FaisalBinHassan/Bioreactor-Vaccine-Production-Plant-for-Tuberculosis/DASHBOARD/dashboard.jpg

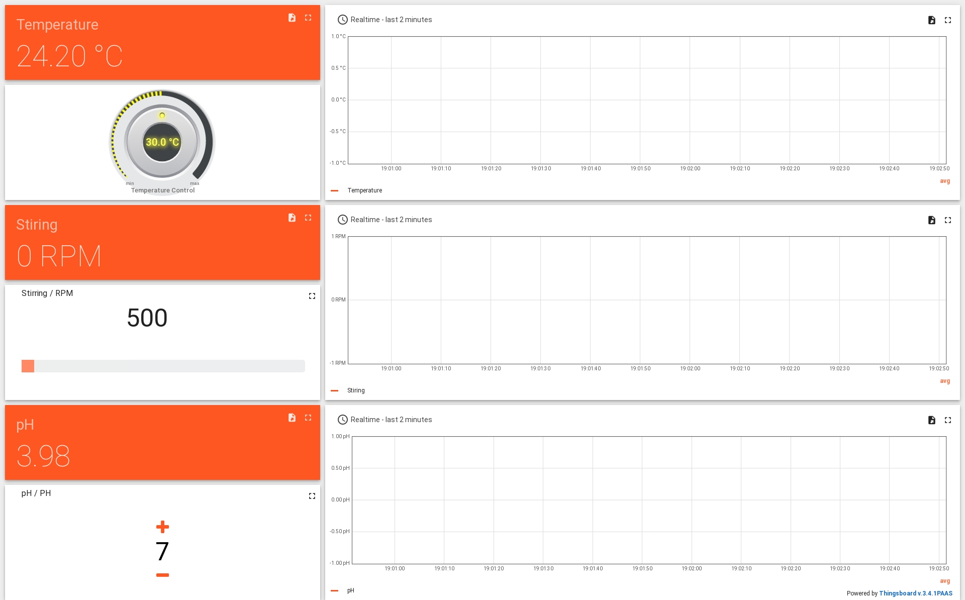
DASHBOARD/dashboard.jpg
