FaisalBinHassan/Bioreactor-Vaccine-Production-Plant-for-Tuberculosis/(commit log)

2022-12-05 Create pH sensor & pump
2022-12-07 Add files via upload
    heating subsystem
2022-12-08 solution for encoding/decoding for i2c
2022-12-13 Final code used in the demonstration (Arduino)
